ManuelBth/process-control-temperature/código/streamControlLibrary/include/common/pins.h

#ifndef COMMON_PINS_H
#define COMMON_PINS_H

#include <stdint.h>

#define PIN_TRIAC         15
#define PIN_ZERO_CROSS    4
#define PIN_MAX6675_SCK   5
#define PIN_MAX6675_MISO 19
#define PIN_MAX6675_CS   23

// Ventiladores PWM (compartido - mismo duty cycle)
#define PIN_FAN1          16
#define PIN_FAN2          17

#endif
