ManuelBth/process-control-temperature/(commit log)

2026-04-13 update: complete conections on adaptative signal for ESP32
    - Realese all conections on components
    - Create surface for GND
    - Checkout the errors when create the baquelita
    [adaptador.kicad_pcb, adaptador.kicad_sch]
2026-04-17 update: resize dimensions for can print on CNC
    - Resize on Edge Cuts layer
    [adaptador.kicad_pcb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]
2026-04-20 feat: add domain stubs - control, sensors, actuation, identification, communication, display modules
2026-04-20 feat: add minimal pins.h with essential pin definitions
2026-04-20 feat: add minimal central_data.h with control and actuator structs
2026-04-20 feat: add zero-cross detector, TRIAC control, and fan control drivers
2026-04-20 feat: add actuation task integrating zero-cross, TRIAC, and fan control
2026-04-20 refactor: remove unused control, sensors, identification, display modules
2026-04-20 refactor: remove old drivers folder and unused communication module
2026-04-20 refactor: simplify actuation state - single boolean per actuator
2026-04-20 refactor: remove fan PWM frequency config, add speed mapping macro
2026-04-20 refactor: implement TRIAC power-to-angle mapping, remove enable/disable
2026-04-20 refactor: update actuation task to use simplified drivers
2026-04-20 refactor: TRIAC reads power directly from global state
2026-04-20 feat: add control config with PID params and modes
2026-04-20 feat: add control data state and sensor placeholder
2026-04-20 feat: add PID algorithm implementation
2026-04-20 feat: add control task with PID loop
2026-04-21 feat: add sensor config with modes and intervals
2026-04-21 feat: add sensor data state with temperature and mode
2026-04-21 feat: add MAX6675 driver with SPI software implementation
2026-04-21 feat: add sensor task with dynamic interval switching
2026-04-21 refactor: remove sensor placeholder, use real sensor data
2026-04-21 feat: add mutexes for temperature and actuation data
2026-04-21 feat: register Sensor, Control, Actuation tasks with core affinity
2026-04-21 refactor: add mutex locking to sensor task
2026-04-21 refactor: TRIAC uses internal power state for thread safety
2026-04-21 Integrate manual control in main loop
    - Call manual_init() in setup()
    - Call manual_loop() in loop() cada 10ms
    - Replaces empty loop()
    [main.cpp]
2026-04-22 feat: migrate to ESP32 DevKit V1 and fix FreeRTOS crashes
    - Migrated platform from Arduino Nano ESP32 to ESP32 DevKit V1
    - Fixed pin mappings for ESP32 DevKit V1:
    - TRIAC: GPIO25, ZERO CROSS: GPIO4, FAN1: GPIO26, FAN2: GPIO27
    - MAX6675: SCK=5, MISO=19, CS=23, RELAY: GPIO14
    - Fixed FreeRTOS task creation issues:
    - Run tasks on Core 1 instead of Core 0
    - Add delays between task creation to prevent double exception
    - Adjust stack sizes and priorities
    - Enable MAX6675 sensor with correct GPIO pins from Random Nerd Tutorial
    - Add debug serial logging in task initialization
    - Disable actuation drivers initially for testing
    The system now boots successfully with 3 tasks running:
    - Sensor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
    [control_task.cpp, main.cpp, max6675.cpp, pins.h]
2026-04-22 feat: add serial commands for PID control (p=start, o=stop, k/i/d=gains)
2026-04-22 fix: include pid.h for pid_reset() declaration
2026-04-22 feat: enable TRIAC drivers for PID control
2026-05-06 feat: add PlatformIO config for ESP32 DevKit v1.1
    - platform = espressif32
    - board = esp32dev
    - framework = arduino
    - monitor_speed = 115200
2026-05-06 feat: add common module with pins and data definitions
    - pins.h: GPIO definitions (TRIAC=3, ZERO_CROSS=4, MAX6675_SCK=5, MAX6675_MISO=19, MAX6675_CS=23)
    - data.h: ControlData struct with temperature, setpoint, PID params, TRIAC delay, zero-cross state
2026-05-06 feat: add control drivers (MAX6675, TRIAC, zero-cross)
    - max6675: SPI bit-banging temperature sensor driver
    - triac: fire control with configurable delay
    - zero_cross: ISR with period measurement for 50Hz detection
2026-05-06 feat: add PID algorithm implementation
    - Anti-windup clamping (integral ±1000)
    - Output clamping (0-100%)
    - Same gains as original: Kp=5, Ki=0.5, Kd=0.2
2026-05-06 feat: add FreeRTOS control task on Core 0
    - ControlTask runs on Core 0 with 200ms loop
    - Reads MAX6675 sensor, calculates PID, fires TRIAC
    - Includes zc_print_status() for zero-cross testing
    - g_data global instance in src/common/data.cpp
2026-05-06 feat: integrate FreeRTOS task in main.cpp
    - setup(): init Serial, drivers, create ControlTask on Core 0
    - loop(): handles serial commands (s=setpoint, p=start, o=stop, z=zc status)
    - Main loop now yields to FreeRTOS scheduler
2026-05-18 fix(ble): add setCallbacks to TX characteristic to enable onWrite reception
    [ble_config.h, ble_handler.cpp, ble_handler.h]
2026-05-18 feat(ble): batch collection with per-sample notifies to avoid L2CAP fragmentation
    [main.cpp]
2026-05-25 refactor: remove deprecated actuation, sensors, rtos modules and manual_control
    - Removed actuation module (fan_control, triac_control, zero_cross, actuation_task)
    - Removed sensors module (max6675 driver, sensor_task)
    - Removed rtos module (task_manager, handles)
    - Removed manual_control (merged into control_data)
    - Removed central_data.h (data.h now handles central data)
    - Removed pins.h (pins defined per-project)
    - Removed mensajes.md from streamControlLibrary (moved to documentation)
2026-05-25 refactor: migrate streamControl to screaming architecture with unified data model
    - Updated data.h to include all shared data structures (queue handles, control data, sensor data, actuation state)
    - Updated triac.h and zero_cross.h drivers in include/control/drivers/
    - Updated control drivers (triac.cpp, zero_cross.cpp) with new initialization
    - Refactored control_task.cpp and zc_triac_task.cpp to use new data model
    - Updated zc_triac_task.h to remove old forward declarations
    - Simplified main.cpp with cleaner task initialization
    - Updated platformio.ini with new build flags
2026-05-27 feat(fan): add perturbation API and modern LEDC support
    - Add FAN_SPEED_NORMAL (70%) and FAN_SPEED_PERTURBATION (100%) constants
    - Add fan_set_perturbation() helper that updates g_data.fan_speed internally
    - Support dual LEDC API: modern (core 3.0+) vs legacy (core 2.x)
    - fan_init() now starts fans immediately at base speed for air homogenization
    - Use PIN-based ledcWrite for core 3.0+ instead of channel-based
2026-05-27 refactor(data): use FAN_SPEED_NORMAL constant instead of magic number
    - Replace hardcoded 20.0f with FAN_SPEED_NORMAL from fan.h
    - Makes initialization consistent with the new fan module constants
2026-05-27 refactor(ble): use fan_set_perturbation() helper in message parser
    - Replace inline fan speed assignment with fan_set_perturbation()
    - Removes direct mutation of g_data.fan_speed from parser logic
    - Keeps fan control logic centralized in the fan module
    [message_parser.cpp]
2026-05-27 refactor(main): remove redundant fan_set_speed() after fan_init()
    - fan_init() now sets base speed internally, so explicit call is redundant
    - Cleaner setup() with single fan initialization line
2026-05-27 fix(pid): reduce max output limit from 100% to 50%
    - Safety change: limit PID output to 50% max power
    - Prevents overheating and excessive thermal stress on the plant
2026-05-27 feat(circuits): add recovered circuito-potencia KiCad project
    - Recovered from git lost-found dangling blob
    - Full KiCad project: .kicad_pcb, .kicad_sch, .kicad_pro, .kicad_prl
    - Power circuit for the thermal control plant
    [circuito-potencia.kicad_pcb, circuito-potencia.kicad_sch]
2026-05-27 feat(circuits): add recovered PCB KiCad projects
    - CONTROLTRIACYCRUCE0: TRIAC zero-cross control board
    - controlesp32: ESP32 control board submodule
    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
    [CONTROLTRIACYCRUCE0.kicad_pcb, CONTROLTRIACYCRUCE0.kicad_sch, controlesp32.kicad_pcb, controlesp32.kicad_sch]
2026-05-27 docs(app): add mobile app PRD and BLE messaging protocol
    - PRD.md: Full Product Requirements Document for Android app
    - Screaming Architecture + MVVM + UDF
    - Jetpack Compose with Vico charts
    - BLE GATT communication spec
    - mensajes.md: BLE JSON protocol specification v2.0
    - Telemetry, mode change, manual control, PID config messages
2026-05-27 docs: reescribe README con documentación enterprise
    - Reemplaza protocolo BLE obsoleto por el formato oficial de app/PRD.md
    - Elimina código/mensajes.md (protocolo viejo)
    - Corrige sensor: termocupla tipo K (MAX6675) en todo el documento
    - Elimina notas de discrepancia y divergencia sensorial
    - Agrega badges de build y estado del proyecto
    - Agrega sección Galería con placeholders de fotos
    - Actualiza estructura del repo y referencias
2026-05-28 docs: elimina toda referencia a app Android del README
    - Remueve sección completa 'Aplicación Móvil (Especificación)'
    - Remueve stack tecnológico de la app (Kotlin, Jetpack Compose, etc.)
    - Remueve galería de la app Android
    - Simplifica protocolo BLE a especificación técnica pura del firmware
    - Remueve referencias a app/PRD.md como fuente oficial del protocolo
    - Agrega diagrama de timing del TRIAC con modulación de fase
    - Agrega sección 'Control de Potencia AC' con secuencia ISR y watchdog
    - Actualiza diagrama de vista general: capa superior es 'Interfaz Inalámbrica (BLE)'
    - Actualiza tabla de contenidos y referencias
