ManuelBth/process-control-temperature/(notices)

Notices in the files:
README.md:
License: MIT
